Jeran64/LendaskMIDI/(commit log)

2019-06-09 Add files via upload
    Arduino IDE code meant for the teensy 3.2
2019-06-13 Update LendaskMIDI.ino
    Realized a smater and simpler way of handling smoothing out electrical noise. by just checking to make sure that the values are not jumping back and forth from the same value over and over, then we can preserve the granularity in at least one of the directions from a stopped position
    [LendaskMIDI.ino]
